bretbosma/Mini-DAQ/Documentation/BOM.pdf

# MiniDAQ Bill of Materials

Designator | Component | Number | Cost per unit -currency | Total cost -currency | Source of materials | Material type
Controller board | Arduino Mega 2560 | 1 | $40.30 | $40.30 | https://store-usa.arduino.cc/products/a rduino-mega-2560-rev3?selecte dStore=us | Electrical Component
EtherCAT board | EasyCAT | 1 | $55.59 | $55.59 | https://www.bausano.net/shop/en/home/1-arduino-ethercat.html | Electrical Component
ADC Evaluation Board | A/D converter | 1 | $55.00 | $55.00 | https://www.mouser.com/ProductDetail/Analog-Devices/DC682A?qs=ytflc lh7QUU1sdP vjEFblQ%3D %3D | Electrical Component
Serial converter | RS232 converter | 1 | $7.90 | $7.90 | https://www.digikey.com/en/products/detail/mikroelektronika/MI KROE-222/4495513 ?s=N4IgTCB cDaILYEMA eYDMEC6BfI A | Electrical Component
Precision resistor | Metal Film Resistor | 1 | $4.39 | $4.39 | https://www.digikey.com/en/products/detail/vishay-dale/PTF65250R00AXEK/6604108?s=N4IgTCBcDa IAoBUBiA2A rGNAGASlrA ggBoCiA0iAL oC%2BQA | Electrical Component
