bretbosma/Mini-DAQ/Documentation/WiringDiagram.pdf

5V

TX

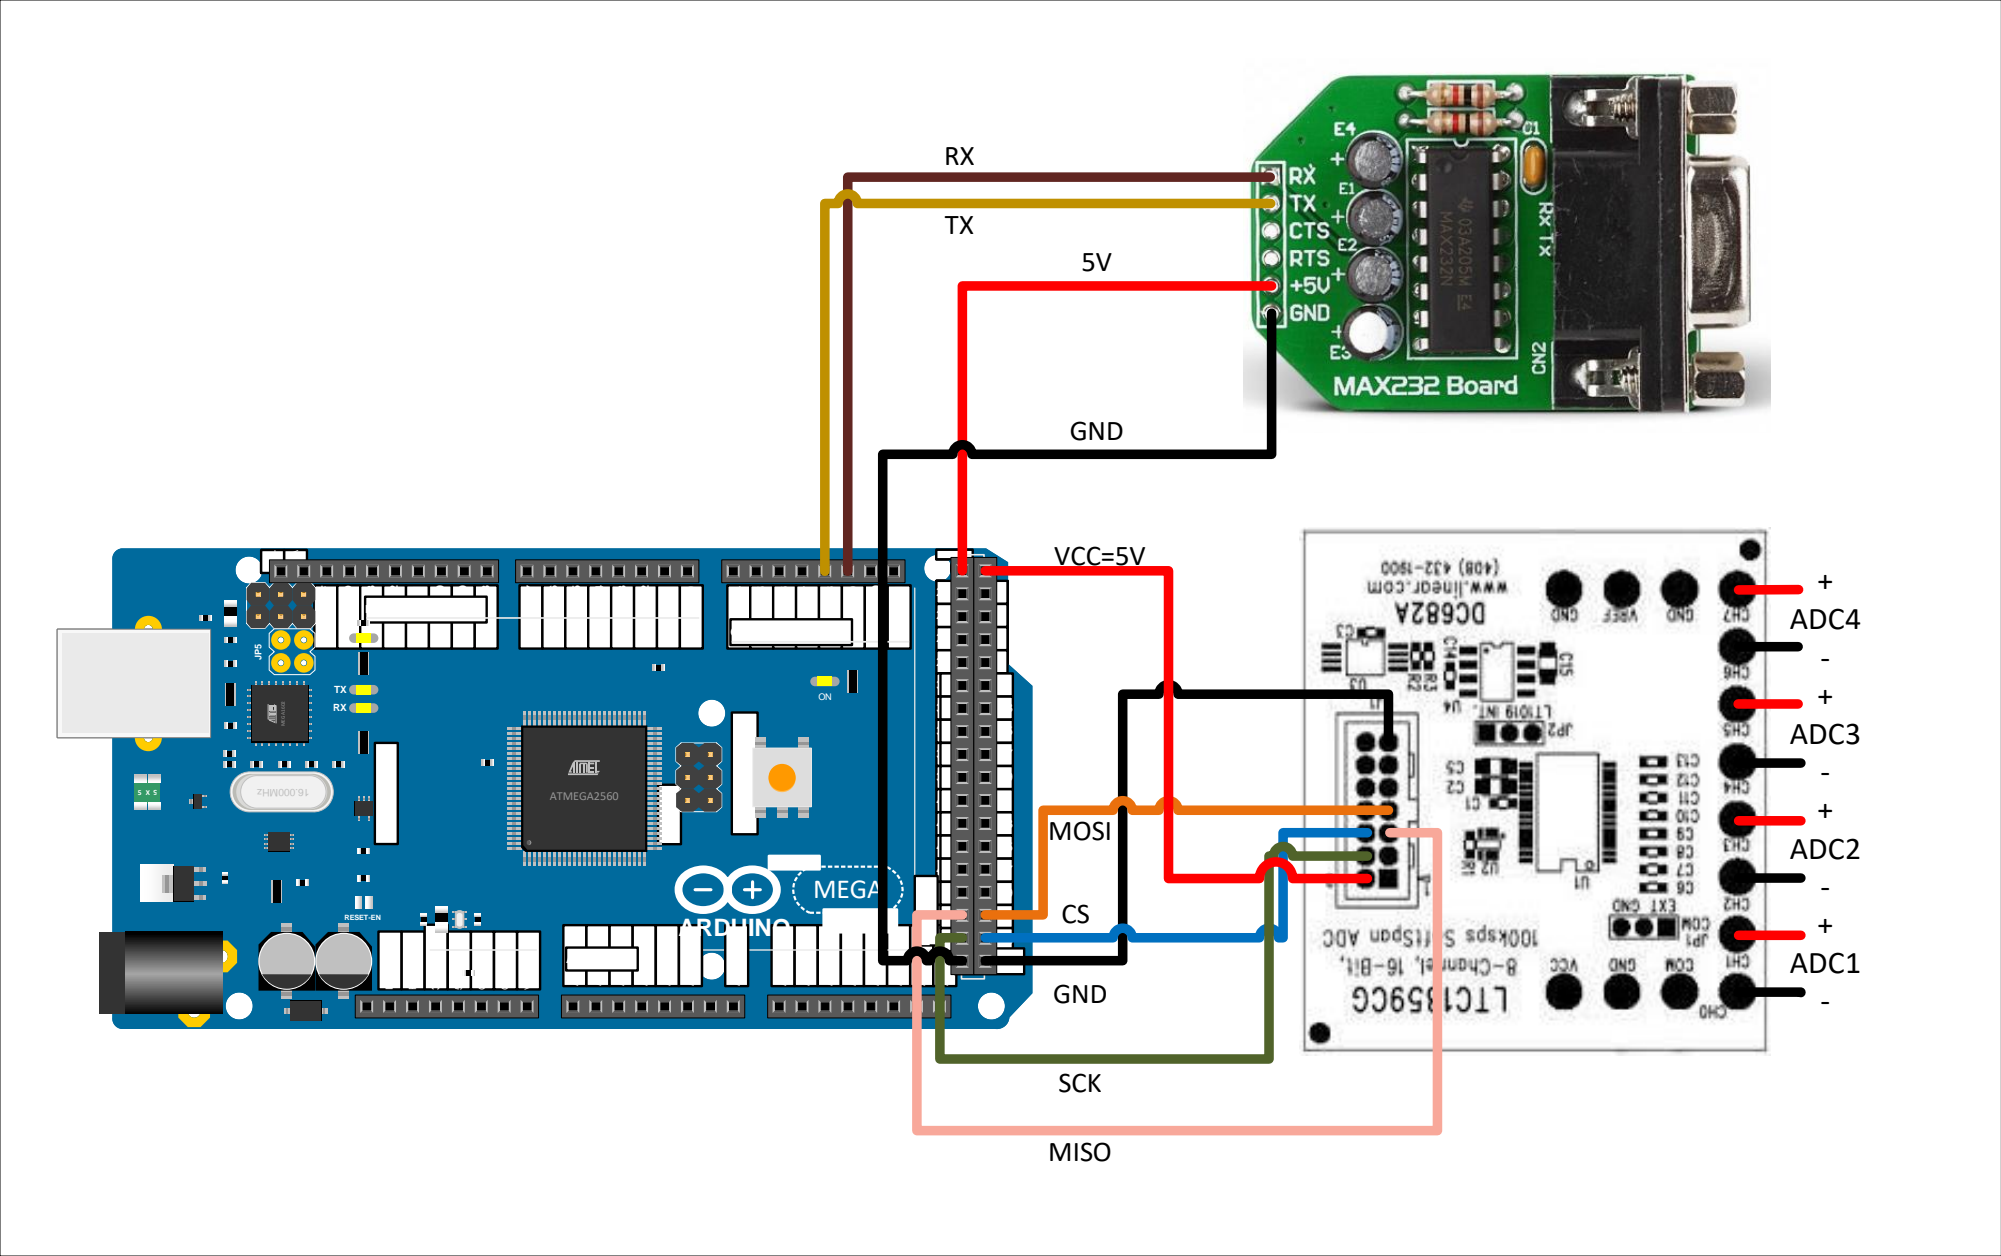
[picture p9: page 1]
POWER; RESET; IOREF; GND; Vin; SDA 20; SCL 21; AREF; RXL; ICSP; COMMUNICATION; PWM; ANALOG IN; DIGITAL; SCL; SDA; 2560 ARDUINO; MEGA; MEGA1602; ATMEGA2560; ADC1 -+; ADC2 -+; ADC3 -+ ADC4 -; VCC=5V; MISO; SCK; MOSI

WWW.ADUINO.CC

+
7.5

# -28VDC -

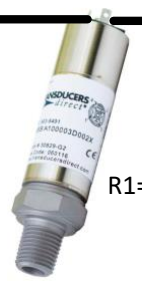
[picture p10: figure]

R1=250

Ω

+

# ADC1 -
