bretbosma/Mini-DAQ/Documentation/GraphicalAbstract.pdf

### speedgoat

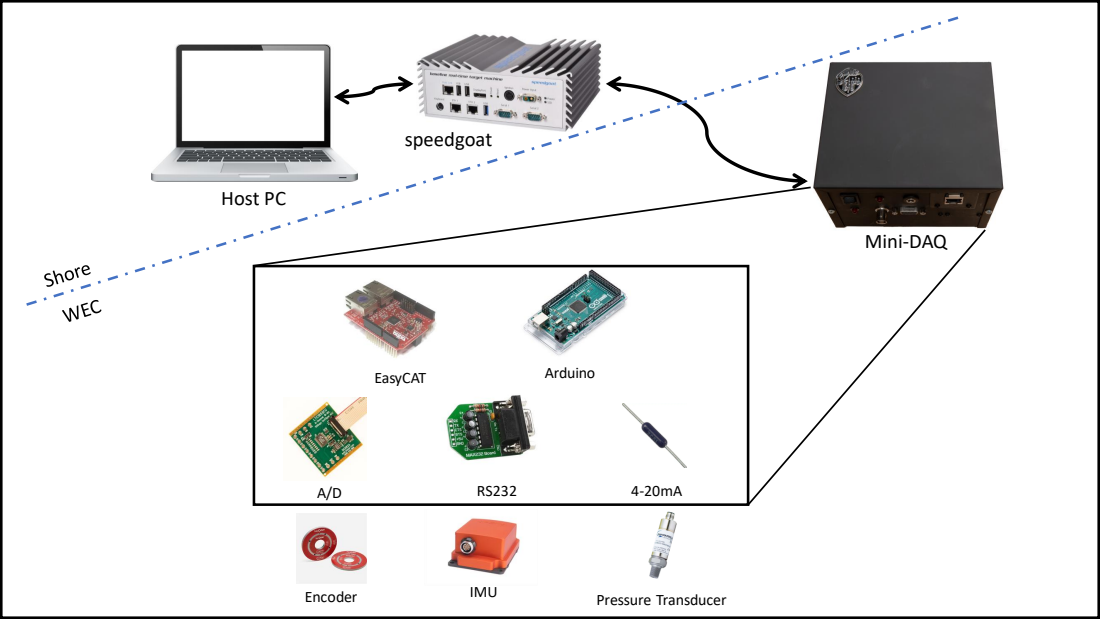
[picture p11: page 1]
Host PC; Mini-DAQ; Arduino EasyCAT; Encoder; IMU; Pressure Transducer
