bretbosma/Mini-DAQ/EasyConfigurator/log_configuration.txt

Easy Configurator, configuration engine  V_3_1 

log created on Tue Dec 01 10:42:24 2020

Analyzing the project file

Easy Configurator project MiniDAQ_FOSWEC_V3.prj

OUTPUTS_TAG
INPUTS_TAG
Line 5 --- ADC0                    uint16_t
Line 6 --- ADC1                    uint16_t
Line 7 --- ADC2                    uint16_t
Line 8 --- ADC3                    uint16_t
Line 9 --- roll                    float
Line 10 --- pitch                   float
Line 11 --- yaw                     float
Line 12 --- acc_x                   float
Line 13 --- acc_y                   float
Line 14 --- acc_z                   float
Line 15 --- temperature             float
Line 16 --- current0                int16_t
INFO_TAG
0x0000060F
Oregon State University, School of Mechanical, Industrial and Manufacturing Engineering, Dynamic Robotics Laboratory
0x03
0x01
MiniDAQ_FOSWEC_V3
MiniDAQ_FOSWEC_V3
END_TAG

The MiniDAQ_FOSWEC_V3.prj configuration file is correct

ByteNumOut 0
ByteNumIn  38
PdoNumOut  0
PdoNumIn   12

Creating the MiniDAQ_FOSWEC_V3.xml file

PROJECT_TAG   MiniDAQ_FOSWEC_V3.prj
VENDOID_TAG   0000060F
VEN_NAM_TAG   Oregon State University, School of Mechanical, Industrial and Manufacturing Engineering, Dynamic Robotics Laboratory
PRO_COD_TAG   03
REVISIO_TAG   01
DEV_NAM_TAG   MiniDAQ_FOSWEC_V3
DEV_NAM_TAG   MiniDAQ_FOSWEC_V3

FIRST_TAG

Output entries

SECOND_TAG

Input entries
          <Entry>
            <Index>#x6</Index>
            <SubIndex>1</SubIndex>
            <BitLen>32</BitLen>
            <Name>roll</Name>
            <DataType>REAL</DataType>
          </Entry>
          <Entry>
            <Index>#x6</Index>
            <SubIndex>2</SubIndex>
            <BitLen>32</BitLen>
            <Name>pitch</Name>
            <DataType>REAL</DataType>
          </Entry>
          <Entry>
            <Index>#x6</Index>
            <SubIndex>3</SubIndex>
            <BitLen>32</BitLen>
            <Name>yaw</Name>
            <DataType>REAL</DataType>
          </Entry>
          <Entry>
            <Index>#x6</Index>
            <SubIndex>4</SubIndex>
            <BitLen>32</BitLen>
            <Name>acc_x</Name>
            <DataType>REAL</DataType>
          </Entry>
          <Entry>
            <Index>#x6</Index>
            <SubIndex>5</SubIndex>
            <BitLen>32</BitLen>
            <Name>acc_y</Name>
            <DataType>REAL</DataType>
          </Entry>
          <Entry>
            <Index>#x6</Index>
            <SubIndex>6</SubIndex>
            <BitLen>32</BitLen>
            <Name>acc_z</Name>
            <DataType>REAL</DataType>
          </Entry>
          <Entry>
            <Index>#x6</Index>
            <SubIndex>7</SubIndex>
            <BitLen>32</BitLen>
            <Name>temperature</Name>
            <DataType>REAL</DataType>
          </Entry>
          <Entry>
            <Index>#x6</Index>
            <SubIndex>8</SubIndex>
            <BitLen>16</BitLen>
            <Name>ADC3</Name>
            <DataType>UINT</DataType>
          </Entry>
          <Entry>
            <Index>#x6</Index>
            <SubIndex>9</SubIndex>
            <BitLen>16</BitLen>
            <Name>ADC0</Name>
            <DataType>UINT</DataType>
          </Entry>
          <Entry>
            <Index>#x6</Index>
            <SubIndex>10</SubIndex>
            <BitLen>16</BitLen>
            <Name>ADC1</Name>
            <DataType>UINT</DataType>
          </Entry>
          <Entry>
            <Index>#x6</Index>
            <SubIndex>11</SubIndex>
            <BitLen>16</BitLen>
            <Name>ADC2</Name>
            <DataType>UINT</DataType>
          </Entry>
          <Entry>
            <Index>#x6</Index>
            <SubIndex>12</SubIndex>
            <BitLen>16</BitLen>
            <Name>current0</Name>
            <DataType>INT</DataType>
          </Entry>

LAST_TAG

The MiniDAQ_FOSWEC_V3.xml file has been created

Creating the MiniDAQ_FOSWEC_V3.h file

#define CUST_BYTE_NUM_OUT	0
#define CUST_BYTE_NUM_IN	38
#define TOT_BYTE_NUM_ROUND_OUT	0
#define TOT_BYTE_NUM_ROUND_IN	40


Output entries

Input entries
		float       roll;
		float       pitch;
		float       yaw;
		float       acc_x;
		float       acc_y;
		float       acc_z;
		float       temperature;
		uint16_t    ADC3;
		uint16_t    ADC0;
		uint16_t    ADC1;
		uint16_t    ADC2;
		int16_t     current0;

The MiniDAQ_FOSWEC_V3.h file has been created

Creating the MiniDAQ_FOSWEC_V3.bin file


The MiniDAQ_FOSWEC_V3.bin file has been created
