bretbosma/Mini-DAQ/(commit log)

2021-06-21 Initial commit of Mini-DAQ files
    [log_configuration.txt]
2021-06-28 Renamed TwinCAT files created 100Hz and 1kHz versions of ESI files implemented 1kHz version
2021-06-29 Renamed and reorganized added final report
    [log_configuration.txt]
2021-07-08 changed gain in ADC outputs to double output
2022-02-01 switching to generic EasyCAT setup to make it easier for the user
2022-02-02 Reconfigured for transferring 32bytes of ethercat data and re-wrote ADC code
2022-02-02 working on IMU data on Simulink side
2022-02-04 IMU working now
2022-02-04 added post processing and support for pressure sensor via ADC4
2022-04-27 added bill of materials
2022-04-28 added wiring diagram
